gkspart01-lgtm/lego-roboter-esp32s3/hardware/3d/adapter_sg90_lego.stl

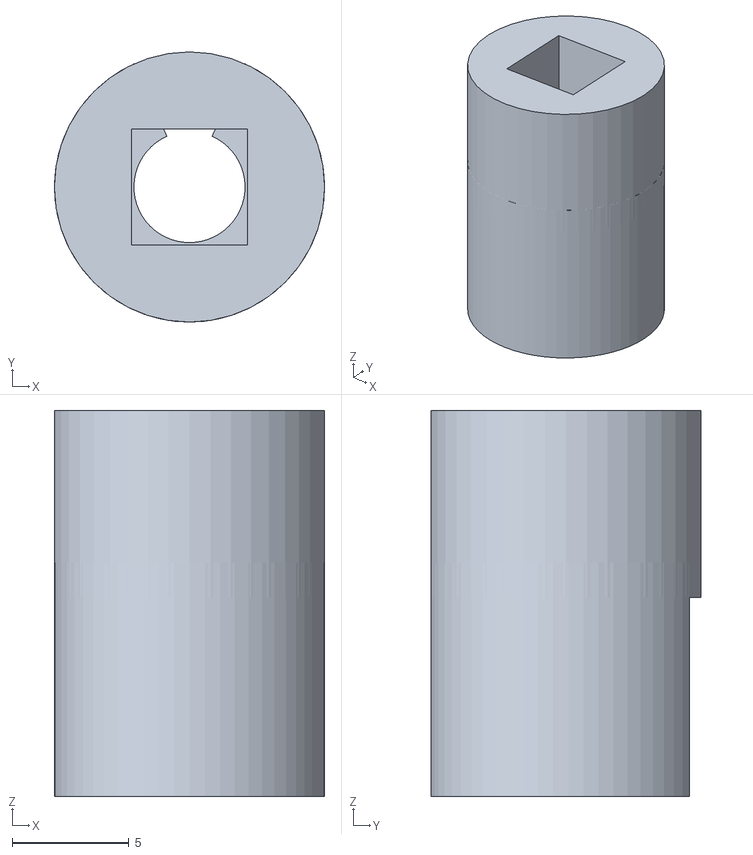
[picture p17: CAD file, 2026-11-11]
hardware/3d/adapter_sg90_lego.stl
11.6 x 11.6 x 16.5
