gkspart01-lgtm/lego-roboter-esp32s3/hardware/3d/adapter_byj48_lego.stl

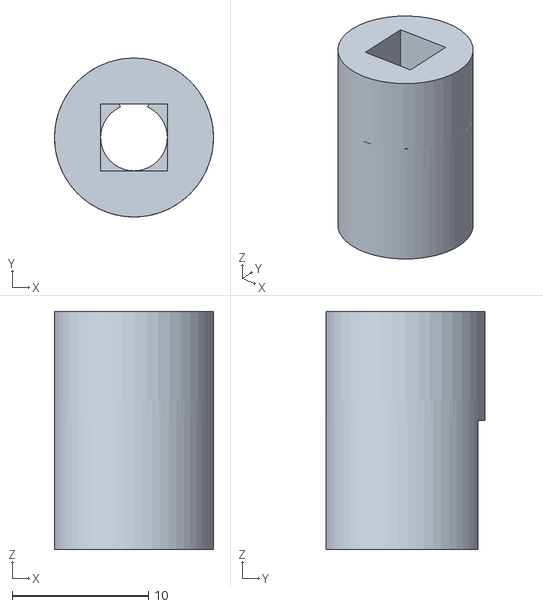
[picture p18: CAD file, 2026-11-11]
hardware/3d/adapter_byj48_lego.stl
11.7 x 11.7 x 17.5
