gkspart01-lgtm/lego-roboter-esp32s3/(list of files, cad)

Other CAD files:
hardware/3d/adapter_tt_lego.stl
