gkspart01-lgtm/lego-roboter-esp32s3/(commit log)

2026-11-11 Steuerplattform ESP32-S3 fuer LEGO-Projekt: Stueckliste, Verkabelung, Blockly
2026-11-11 Bilder reparieren (Formate/Pfade) + 3D-Adapter: STL, OpenSCAD, Renderings und gepruefte Fremdmodelle
    [adapter_byj48_lego.stl, adapter_lego_axle.scad, adapter_sg90_lego.stl, adapter_tt_lego.stl]
2026-11-12 Verkabelung: Pin-fuer-Pin-SVG-Diagramme statt Mermaid, mit Layout-Pruefung
2026-11-13 Board als Platinenansicht mit farbcodierten Pins + Variante ohne Kamera (DevKitC-1)
